pa3axa/EasyBeacon/EasyBeacon_1.1.jpg

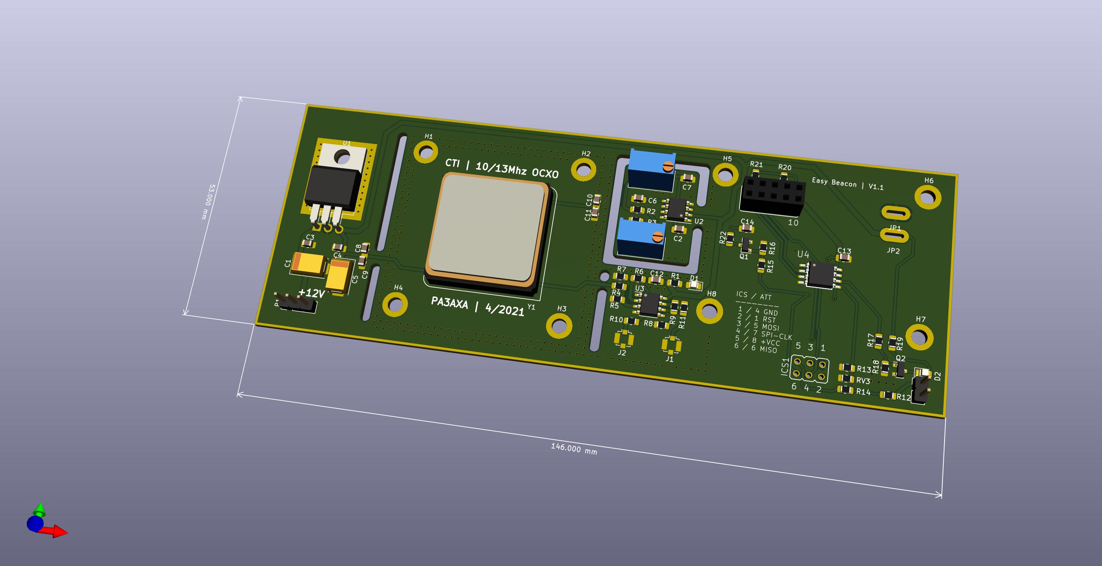
EasyBeacon_1.1.jpg
