pa3axa/EasyBeacon/EasyBeacon_1.0.jpg

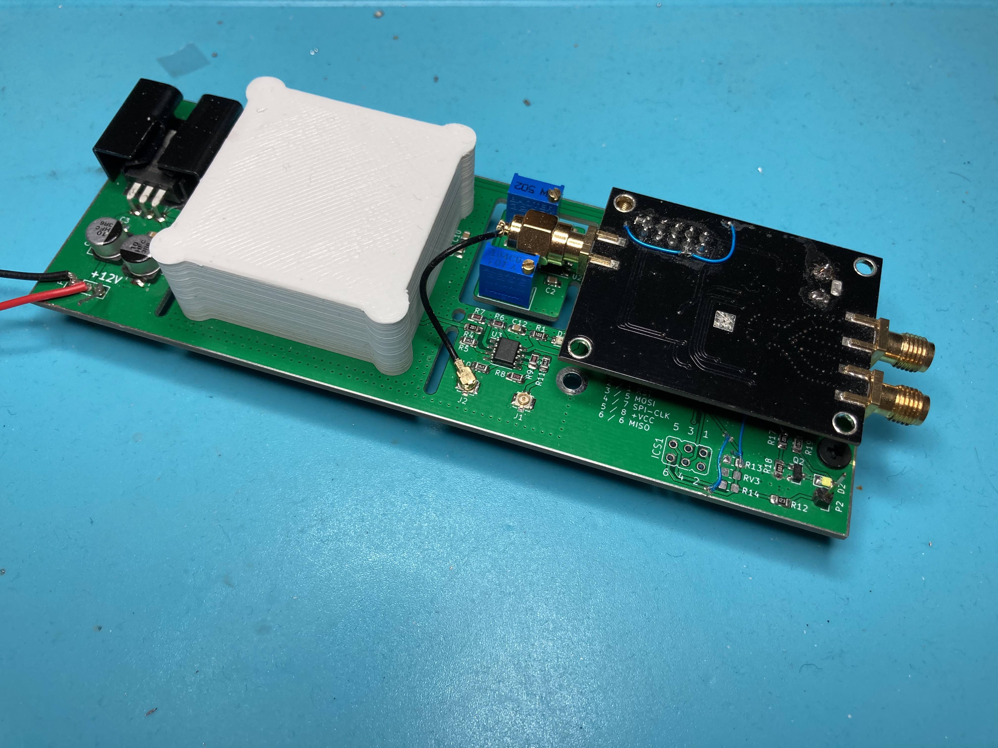
EasyBeacon_1.0.jpg
