pa3axa/EasyBeacon/PI4-TX.png

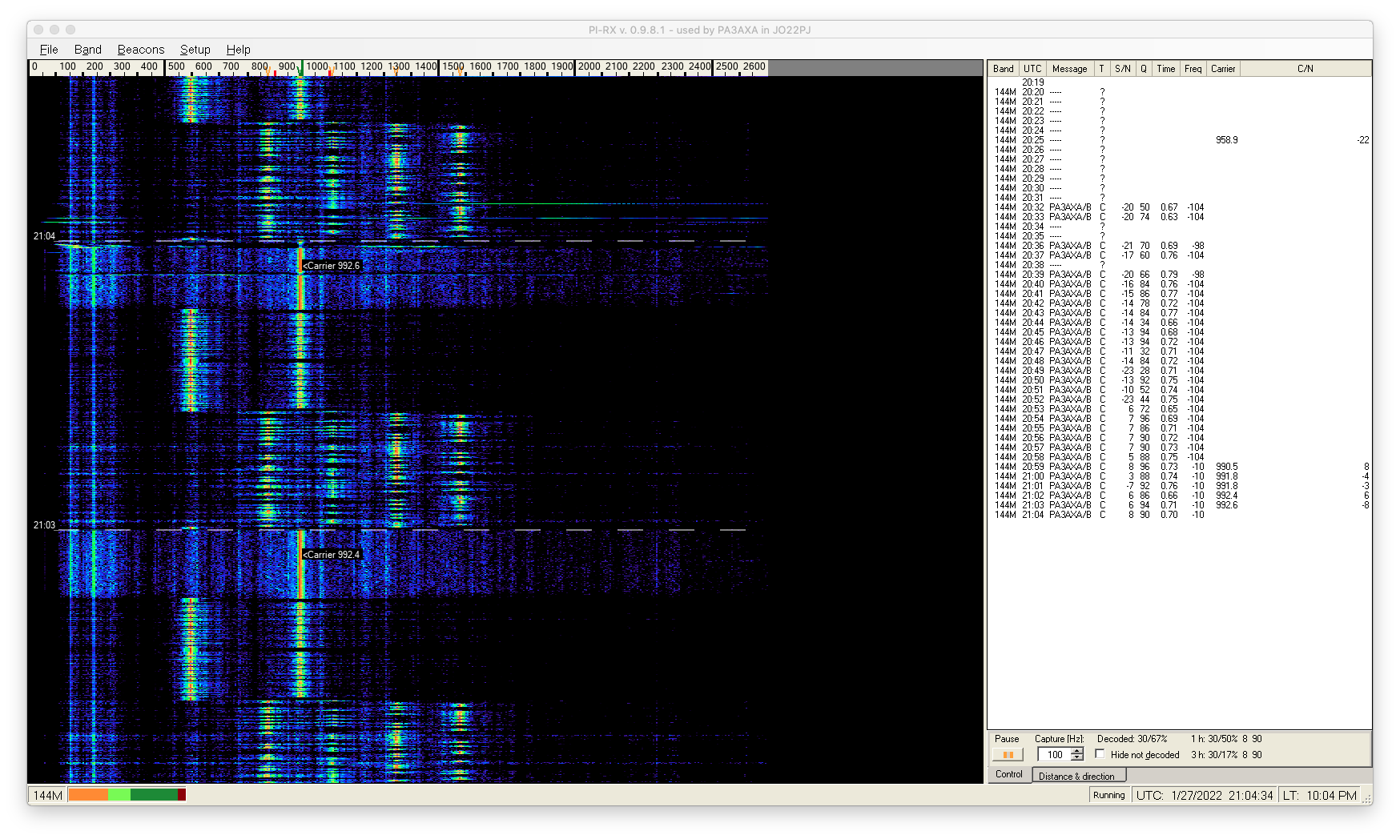
PI4-TX.png
