pa3axa/EasyBeacon/Master_BEACON_BOM.xlsx

Source: | /Master_Beacon/Master_BEACON_V1.1/Master_BEACON_V1.1.sch
Date: | 2022 February 01, Tuesday 19:50:55
Tool: | Eeschema (6.0.0-0)
Component Count: | 56
Components:
Item | Qty | Reference(s) | Value | Footprint
1 | 2 | C1, C5 | 10u | Capacitor_Tantalum_SMD:CP_EIA-7343-31_Kemet-D
2 | 2 | C2, C6 | 1u | Capacitor_SMD:C_0805_2012Metric_Pad1.18x1.45mm_HandSolder
3 | 1 | C3 | 330n | Capacitor_SMD:C_0805_2012Metric_Pad1.18x1.45mm_HandSolder
4 | 7 | C4, C7, C8, C9, C10, C11, C12 | 100n | Capacitor_SMD:C_0805_2012Metric_Pad1.18x1.45mm_HandSolder
5 | 2 | C13, C14 | 100n | Capacitor_SMD:C_0805_2012Metric_Pad1.18x1.45mm_HandSolder
6 | 2 | D1, D2 | LED | LED_SMD:LED_0805_2012Metric_Pad1.15x1.40mm_HandSolder
10 | 1 | J1 | Conn_Coaxial | Connector_Coaxial:U.FL_Molex_MCRF_73412-0110_Vertical
11 | 1 | J2 | Conn_Coaxial | Connector_Coaxial:U.FL_Molex_MCRF_73412-0110_Vertical
12 | 1 | J3 | Conn_01x02_Male | Connector_PinHeader_2.54mm:PinHeader_1x02_P2.54mm_Vertical
13 | 2 | JP1, JP2 | PINHD-1X1 | RF_PA3AXA:MountingOval_1x4mm_Pad
14 | 1 | MOD1 | ADF4351PLL | RF_PA3AXA:ADF4351
15 | 1 | P1 | Conn_01x03_Male | Connector_PinHeader_2.54mm:PinHeader_1x03_P2.54mm_Vertical
16 | 2 | Q1, Q2 | 2N7002 | Package_TO_SOT_SMD:SOT-23
17 | 5 | R1, R16, R18, R20, R21 | 10k | Resistor_SMD:R_0805_2012Metric_Pad1.20x1.40mm_HandSolder
18 | 3 | R2, R15, R17 | 1k | Resistor_SMD:R_0805_2012Metric_Pad1.20x1.40mm_HandSolder
19 | 2 | R3, R4 | 0 | Resistor_SMD:R_0805_2012Metric_Pad1.20x1.40mm_HandSolder
20 | 3 | R5, R10, R11 | 49.9 | Resistor_SMD:R_0805_2012Metric_Pad1.20x1.40mm_HandSolder
21 | 4 | R6, R7, R8, R9 | 500 | Resistor_SMD:R_0805_2012Metric_Pad1.20x1.40mm_HandSolder
22 | 1 | R12 | 12k | Resistor_SMD:R_0805_2012Metric_Pad1.20x1.40mm_HandSolder
23 | 1 | R13 | 4k7 | Resistor_SMD:R_0805_2012Metric_Pad1.20x1.40mm_HandSolder
24 | 1 | R14 | N.C. | Resistor_SMD:R_0805_2012Metric_Pad1.20x1.40mm_HandSolder
25 | 1 | R19 | 2k4 | Resistor_SMD:R_0805_2012Metric_Pad1.20x1.40mm_HandSolder
26 | 1 | R22 | 110 | Resistor_SMD:R_0805_2012Metric_Pad1.20x1.40mm_HandSolder
27 | 1 | RV1 | 5k | Potentiometer_THT:Potentiometer_Bourns_3296Y_Vertical
28 | 1 | RV2 | 10k | Potentiometer_THT:Potentiometer_Bourns_3296Y_Vertical
29 | 1 | RV3 | - | Resistor_SMD:R_0805_2012Metric_Pad1.20x1.40mm_HandSolder
30 | 1 | SV1 | FE05-2 | RF_PA3AXA:FE05-2
31 | 1 | U1 | uA7805 | Package_TO_SOT_THT:TO-220-3_Horizontal_TabDown
32 | 1 | U2 | REF5040ID | Package_SO:SOIC-8_3.9x4.9mm_P1.27mm
33 | 1 | U3 | MAX4016ESA | Package_SO:SOIC-8_3.9x4.9mm_P1.27mm
34 | 1 | U4 | ATTINY85SU | RF_PA3AXA:ATTINY85
35 | 1 | Y1 | OSC5A2B | RF_PA3AXA:OSC5A2B
