pa3axa/EasyBeacon/EasyBeacon_1.1.pdf

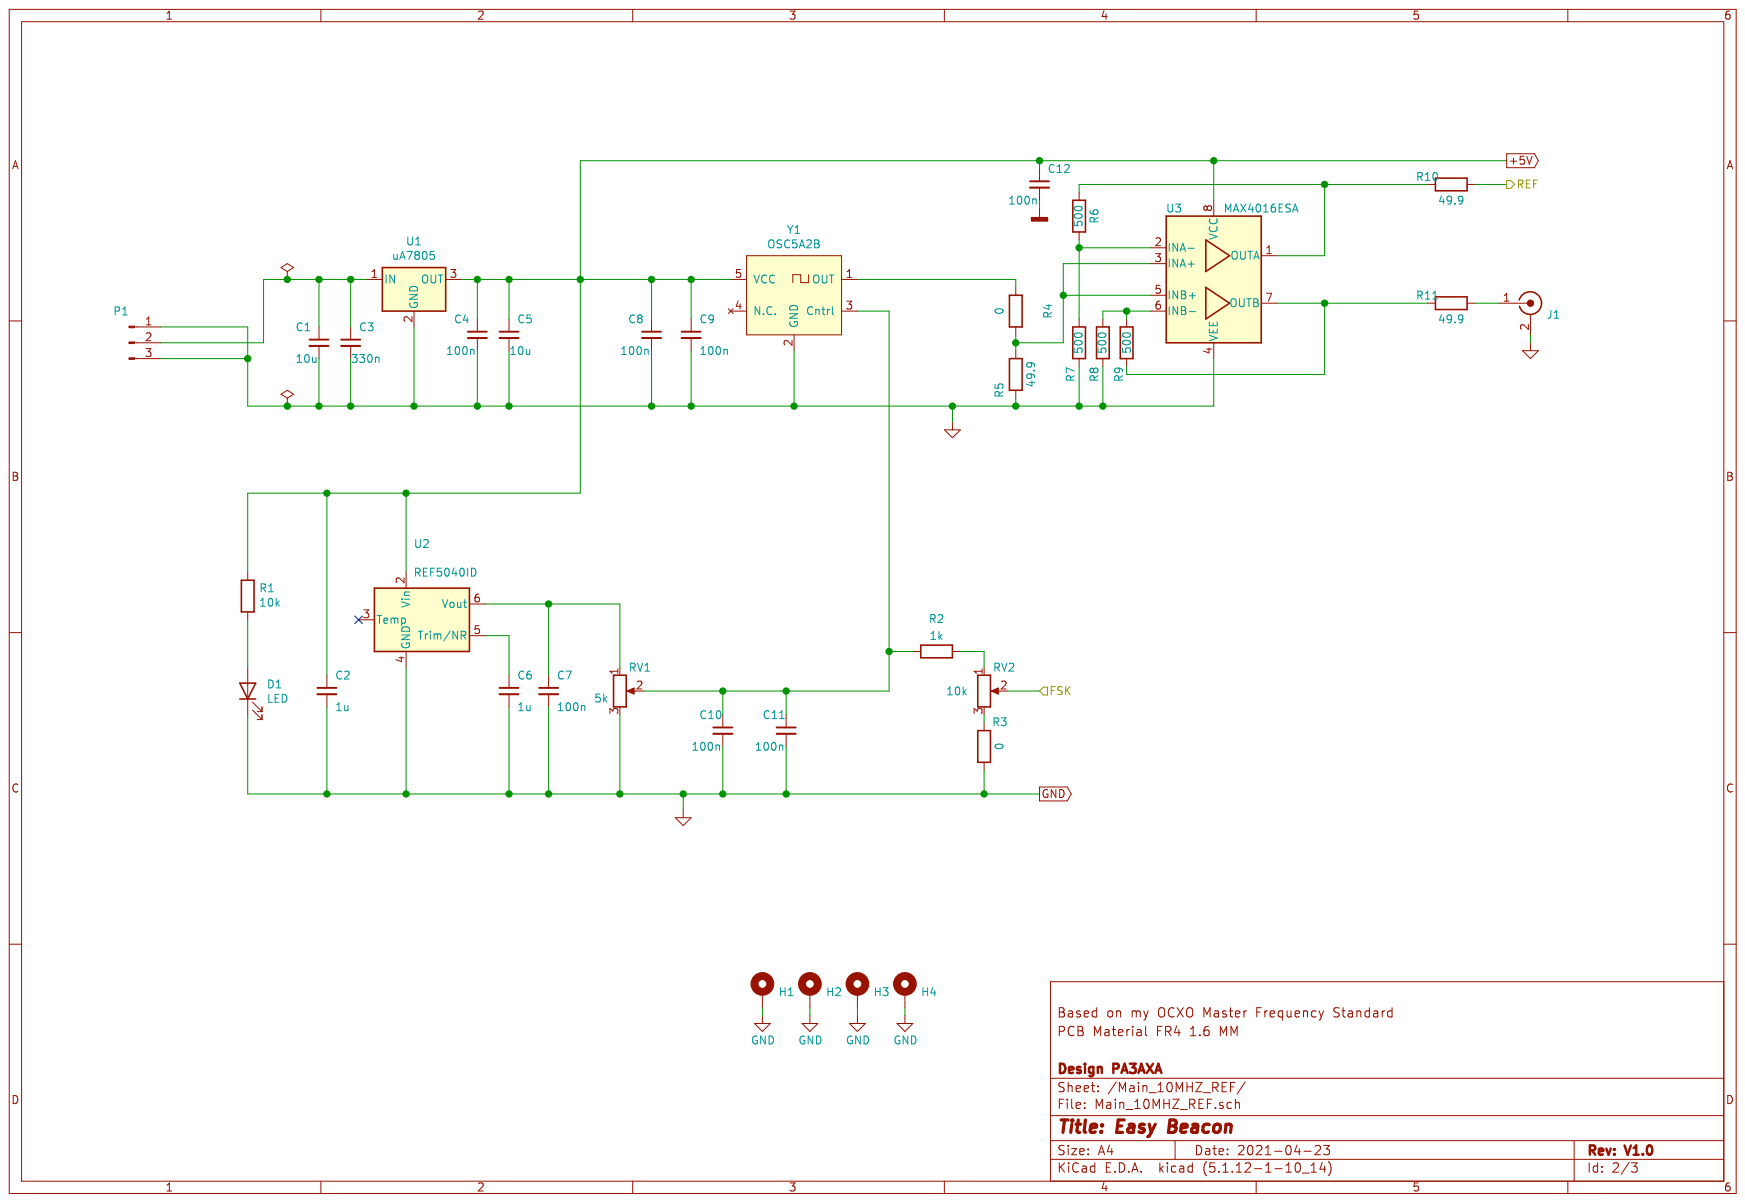
[picture p4: page 1]

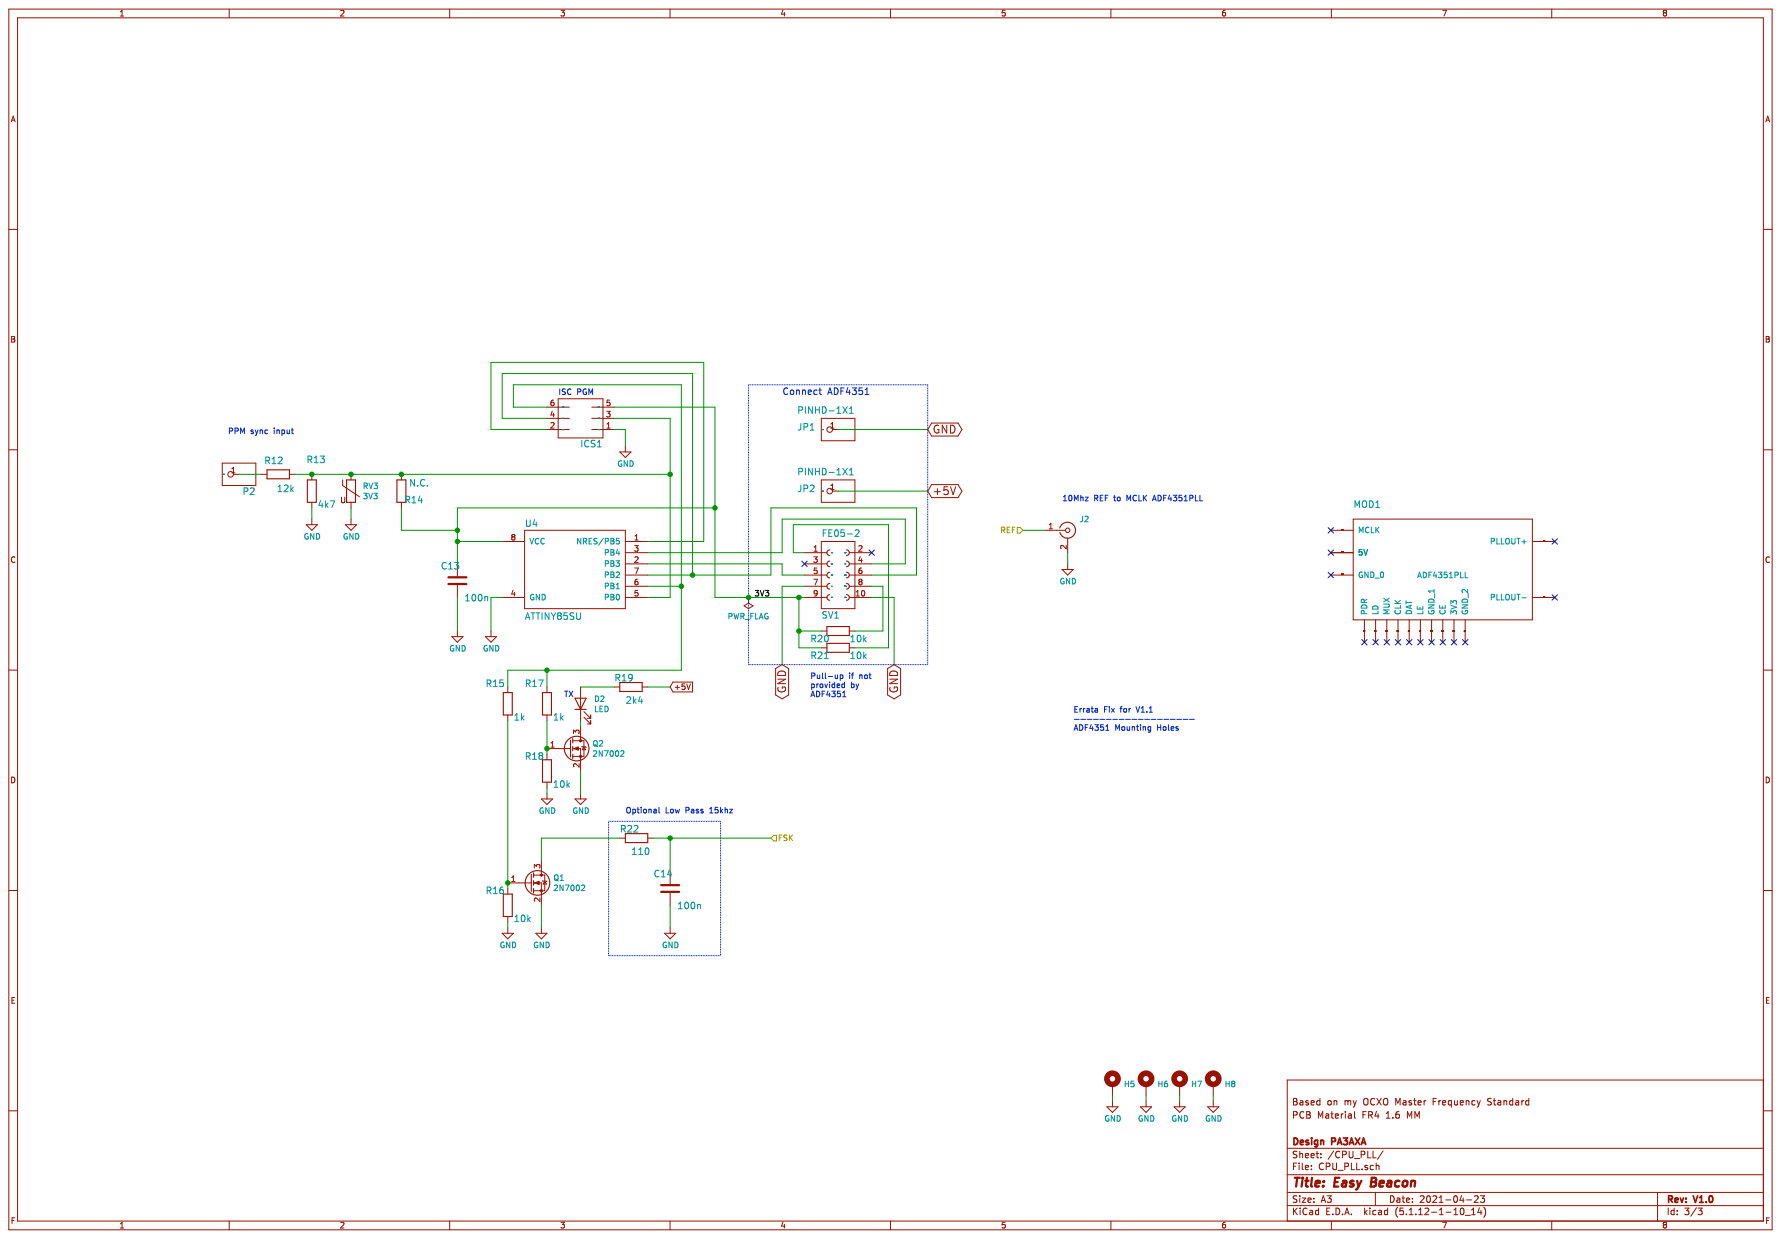
[picture p5: page 2]
