pa3axa/EasyBeacon/(commit log)

2022-01-14 Update Master_BEACON_V1.1.jpg
    Added Board Size
2022-02-01 Added BOM
    [Master_BEACON_BOM.xlsx]
2022-02-04 Add Prototype Picture
2022-03-22 Reduced noise near Carrier
    [PI7ALK_ADF43XX_PWM_V1.1.ino]
